ayberktarcin/ai-pcb-lab/AI_KiCad_Test/kicad/AI_KiCad_Test.kicad_pcb

## KiCad design AI_KiCad_Test/kicad/AI_KiCad_Test.kicad_pcb (2026-10-09)

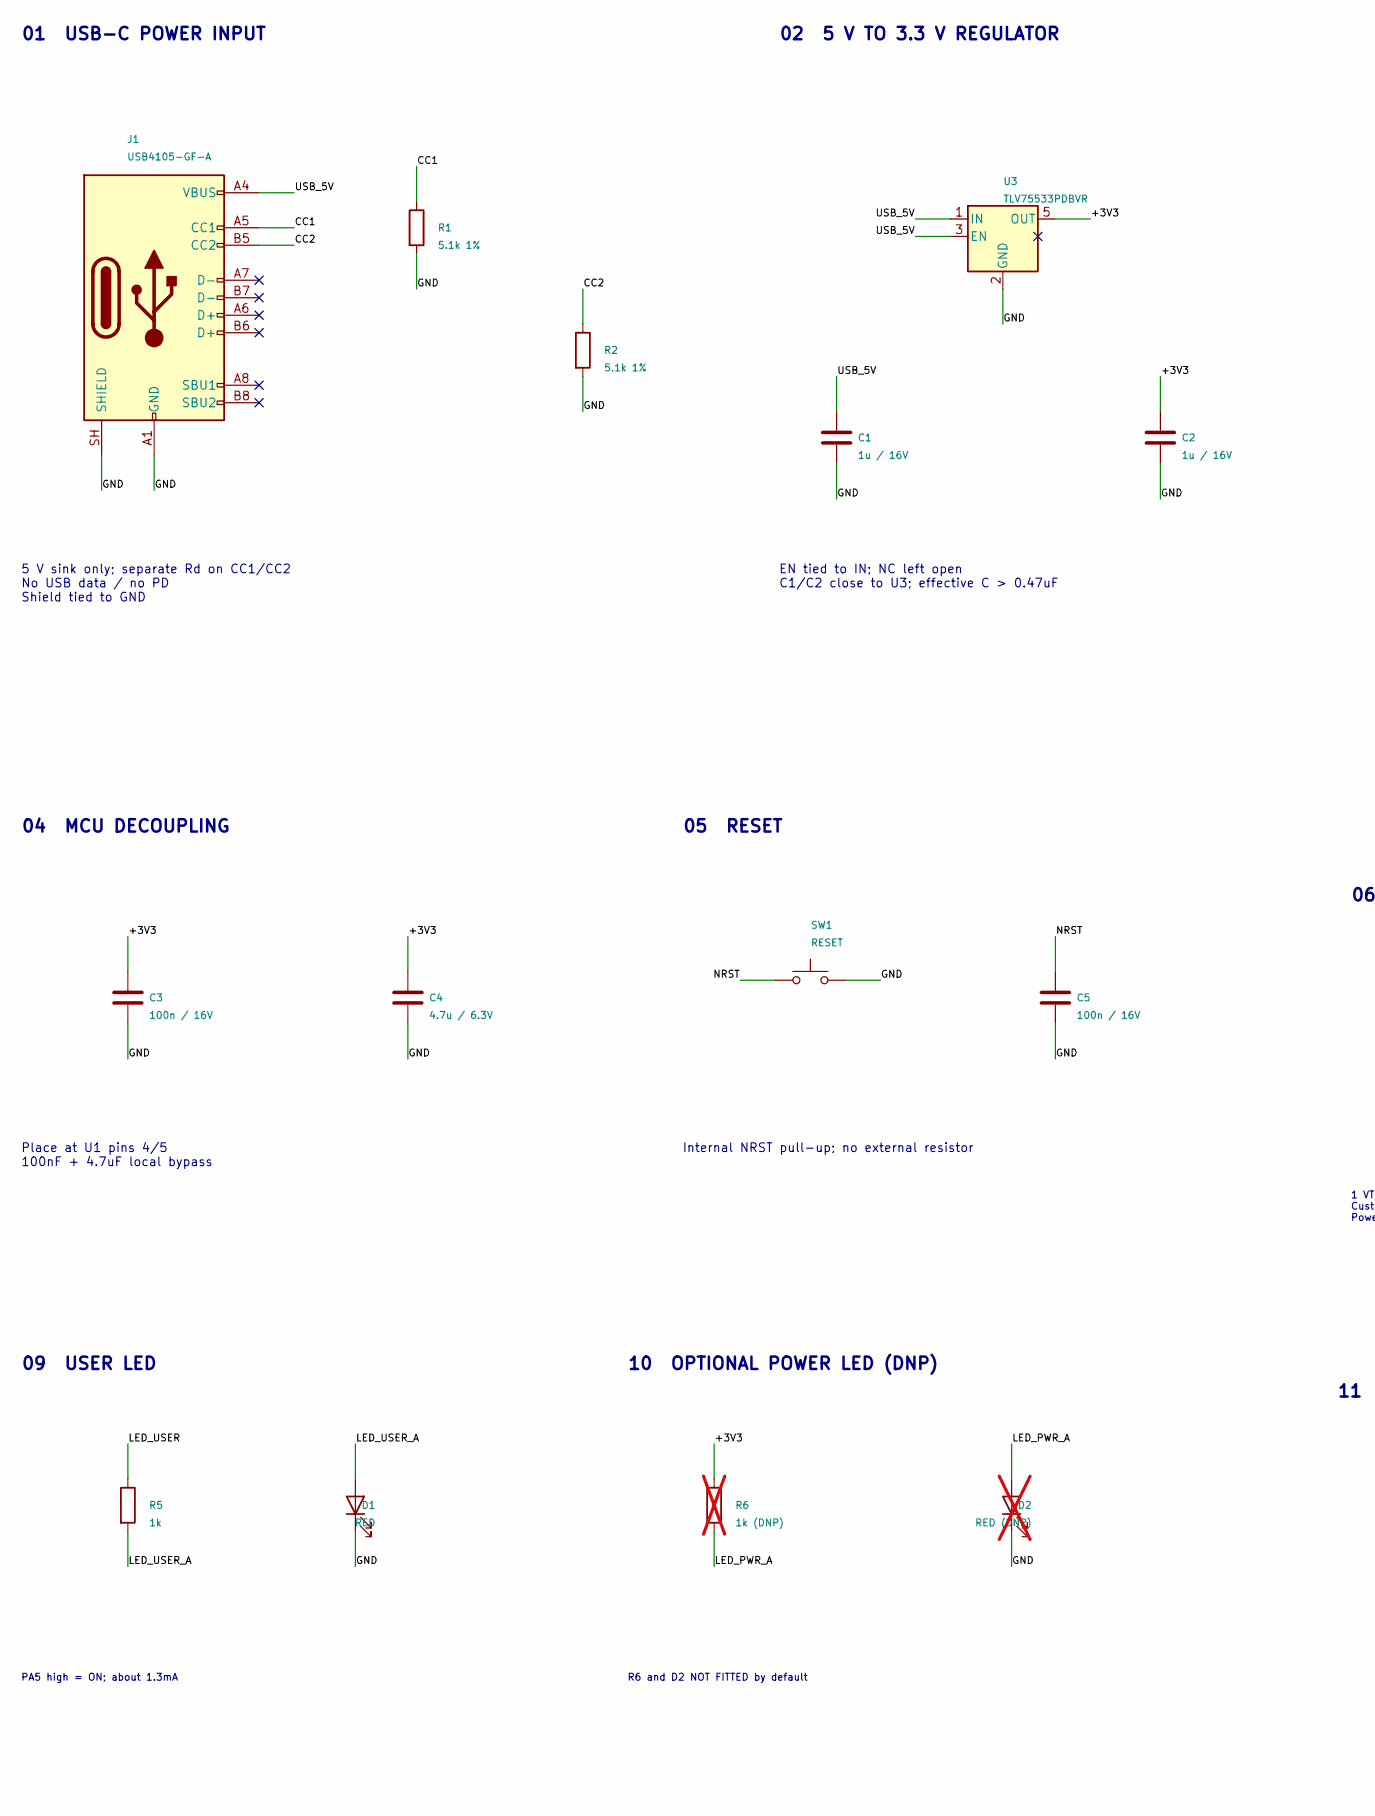
[picture p1: schematic AI_KiCad_Test.kicad_sch, STM32G031 + TMP102 Sensor Board, part in row 1, column 1]

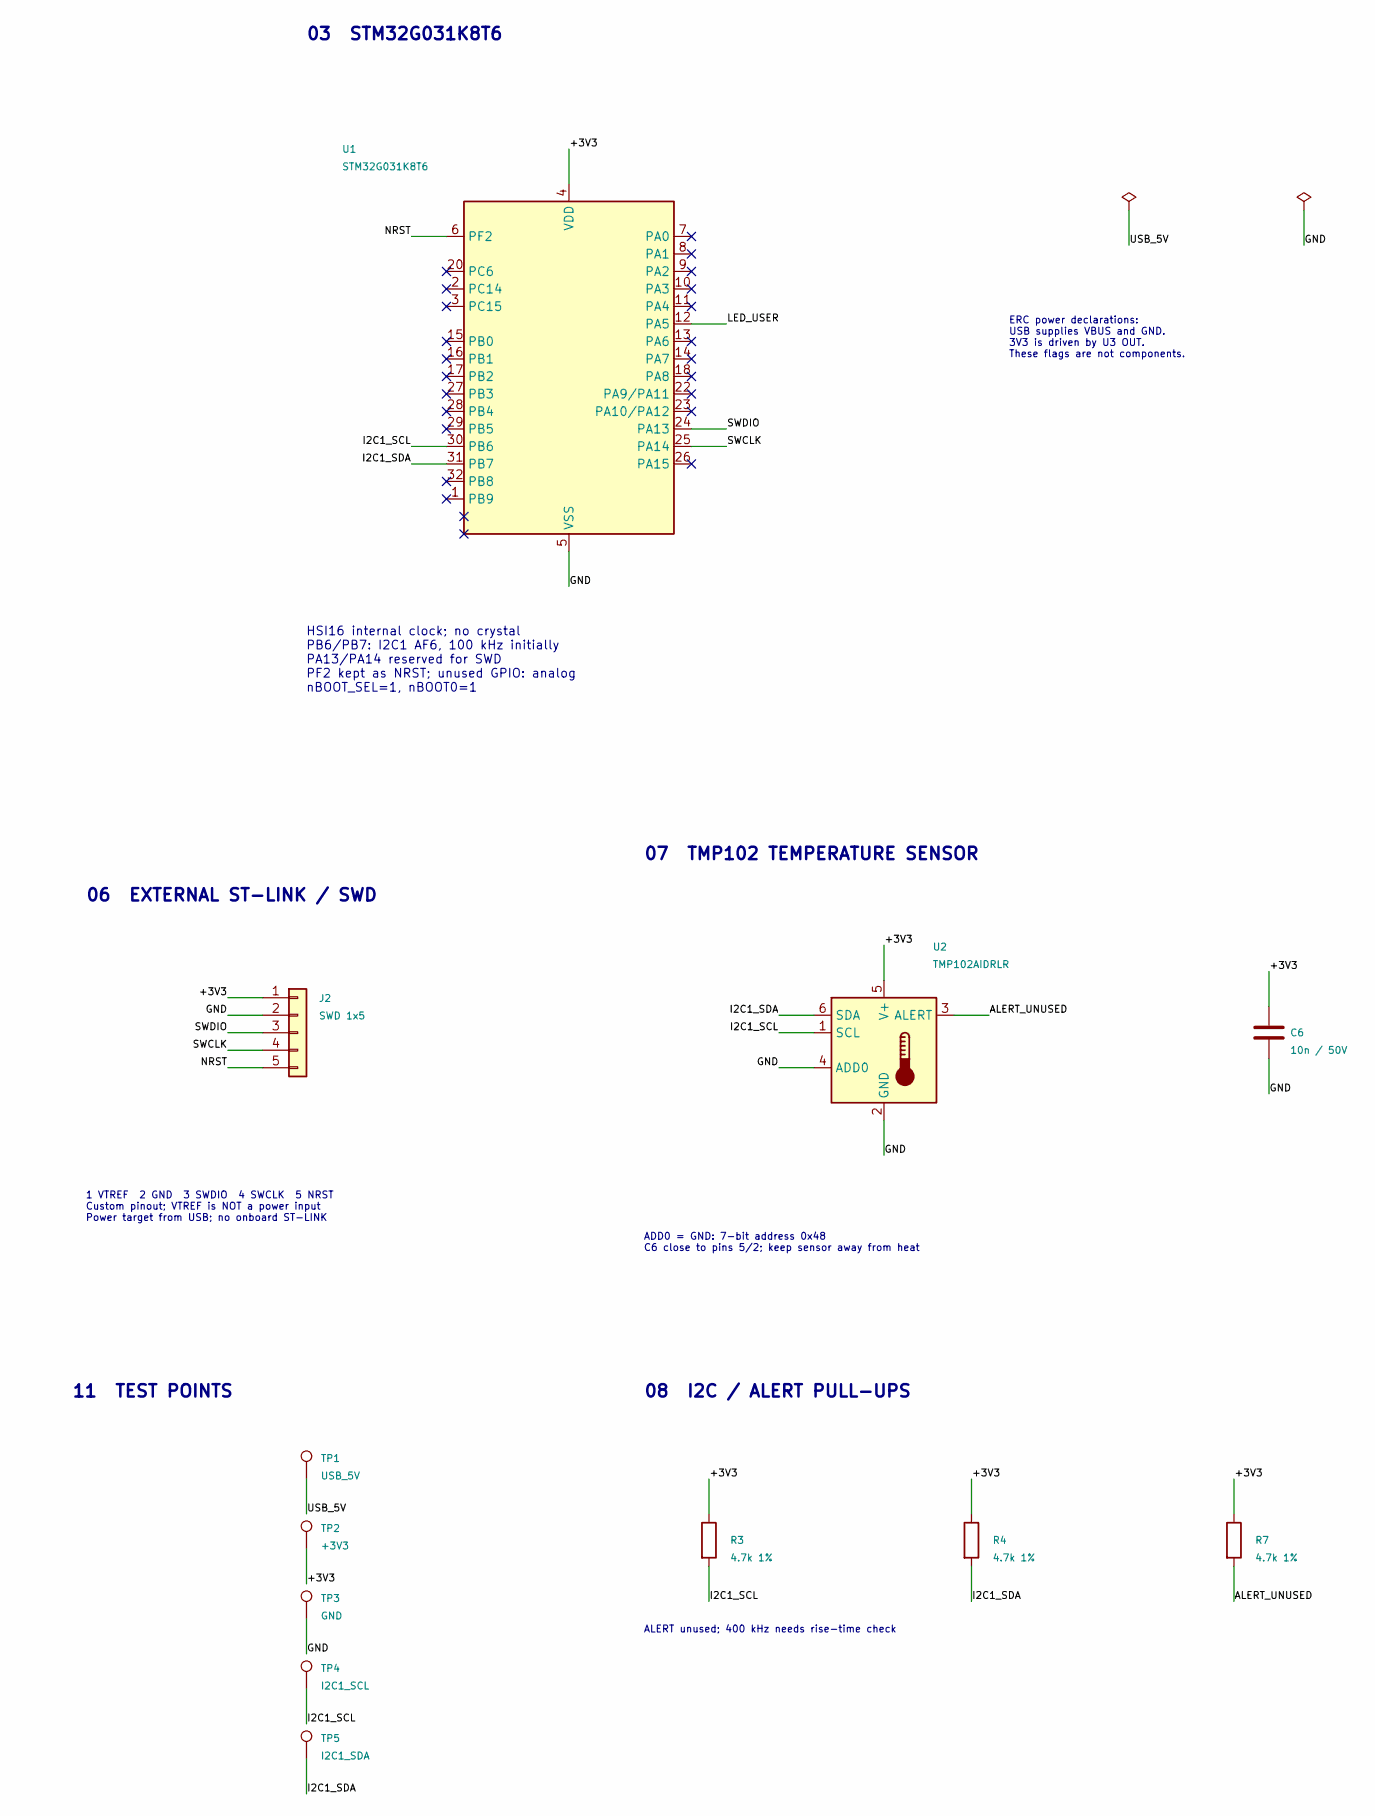
[picture p2: schematic AI_KiCad_Test.kicad_sch, STM32G031 + TMP102 Sensor Board, part in row 1, column 2]

Parts:
C1, C2: 1u / 16V; C_0603_1608Metric; MPN C1608X7R1C105K080AC
C3, C5: 100n / 16V; C_0603_1608Metric; MPN GRM188R71C104KA01D
C4: 4.7u / 6.3V; C_0603_1608Metric; MPN GRM188R60J475KE19D
C6: 10n / 50V; C_0603_1608Metric; MPN C1608X7R1H103K080AA
D1: RED; LED_0603_1608Metric; MPN LTST-C190KRKT
D2: RED (DNP); LED_0603_1608Metric; MPN LTST-C190KRKT; not fitted
J1: USB4105-GF-A; USB_C_Receptacle_GCT_USB4105-xx-A_16P_TopMnt_Horizontal; MPN USB4105-GF-A
J2: SWD 1x5; PinHeader_1x05_P2.54mm_Vertical; MPN TSW-105-07-G-S
R1, R2: 5.1k 1%; R_0603_1608Metric; MPN RC0603FR-075K1L
R3, R4, R7: 4.7k 1%; R_0603_1608Metric; MPN RC0603FR-074K7L
R5: 1k; R_0603_1608Metric; MPN RC0603FR-071KL
R6: 1k (DNP); R_0603_1608Metric; MPN RC0603FR-071KL; not fitted
SW1: RESET; SW_Tactile_SPST_NO_Straight_CK_PTS636Sx25SMTRLFS; MPN PTS636 SK25 SMTR LFS
TP1: USB_5V; TestPoint_Pad_D1.5mm; MPN USB_5V
TP2: +3V3; TestPoint_Pad_D1.5mm; MPN +3V3
TP3: GND; TestPoint_Pad_D1.5mm; MPN GND
TP4: I2C1_SCL; TestPoint_Pad_D1.5mm; MPN I2C1_SCL
TP5: I2C1_SDA; TestPoint_Pad_D1.5mm; MPN I2C1_SDA
U1: STM32G031K8T6; LQFP-32_7x7mm_P0.8mm; MPN STM32G031K8T6
U2: TMP102AIDRLR; SOT-563; MPN TMP102AIDRLR
U3: TLV75533PDBVR; SOT-23-5; MPN TLV75533PDBVR

Connections:
/+3V3: C2.1, C3.1, C4.1, C6.1, J2.1, R3.1, R4.1, R6.1, R7.1, TP2.1 (1_1), U1.4 (VDD), U2.5 (V+), U3.5 (OUT)
/ALERT_UNUSED: R7.2, U2.3 (ALERT)
/CC1: J1.A5 (CC1), R1.1
/CC2: J1.B5 (CC2), R2.1
/GND: C1.2, C2.2, C3.2, C4.2, C5.2, C6.2, D1.1 (K), D2.1 (K), J1.A1 (GND), J1.A12 (GND), J1.B1 (GND), J1.B12 (GND), J1.SH (SHIELD), J2.2, R1.2, R2.2, SW1.2, TP3.1 (1_1), U1.5 (VSS), U2.2 (GND), U2.4 (ADD0), U3.2 (GND)
/I2C1_SCL: R3.2, TP4.1 (1_1), U1.30 (PB6), U2.1 (SCL)
/I2C1_SDA: R4.2, TP5.1 (1_1), U1.31 (PB7), U2.6 (SDA)
/LED_PWR_A: D2.2 (A), R6.2
/LED_USER: R5.1, U1.12 (PA5)
/LED_USER_A: D1.2 (A), R5.2
/NRST: C5.1, J2.5, SW1.1, U1.6 (PF2)
/SWCLK: J2.4, U1.25 (PA14)
/SWDIO: J2.3, U1.24 (PA13)
/USB_5V: C1.1, J1.A4 (VBUS), J1.A9 (VBUS), J1.B4 (VBUS), J1.B9 (VBUS), TP1.1 (1_1), U3.1 (IN), U3.3 (EN)

Notes on the sheet:
ALERT unused; 400 kHz needs rise-time check
08 I2C / ALERT PULL-UPS
09 USER LED
PA5 high = ON; about 1.3mA
02 5 V TO 3.3 V REGULATOR
01 USB-C POWER INPUT
5 V sink only; separate Rd on CC1/CC2 No USB data / no PD Shield tied to GND
10 OPTIONAL POWER LED (DNP)
1 VTREF 2 GND 3 SWDIO 4 SWCLK 5 NRST Custom pinout; VTREF is NOT a power input Power target from USB; no onboard ST-LINK
ERC power declarations: USB supplies VBUS and GND. 3V3 is driven by U3 OUT. These flags are not components.
EN tied to IN; NC left open C1/C2 close to U3; effective C > 0.47uF
11 TEST POINTS
R6 and D2 NOT FITTED by default
03 STM32G031K8T6
Place at U1 pins 4/5 100nF + 4.7uF local bypass
ADD0 = GND: 7-bit address 0x48 C6 close to pins 5/2; keep sensor away from heat
04 MCU DECOUPLING
05 RESET
Internal NRST pull-up; no external resistor
06 EXTERNAL ST-LINK / SWD
HSI16 internal clock; no crystal PB6/PB7: I2C1 AF6, 100 kHz initially PA13/PA14 reserved for SWD PF2 kept as NRST; unused GPIO: analog nBOOT_SEL=1, nBOOT0=1
07 TMP102 TEMPERATURE SENSOR

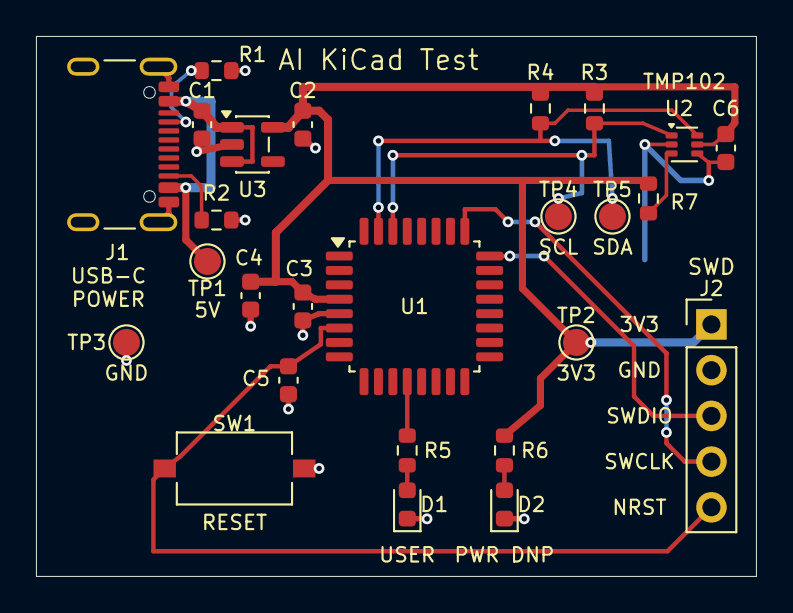
[picture p3: board AI_KiCad_Test.kicad_pcb from above]

Board: 2 copper layers, 40.0 x 30.0 mm, 26 parts (0 on the bottom side), 14 nets.
